Quil180/JuniorDesign/Reports/week6/Awad_Yousef_Week6.tex

\documentclass[12pt, letterpaper]{article}

% Required Packages
\usepackage[utf8]{inputenc}
\usepackage[margin=1in]{geometry}
\usepackage{graphicx}   % For including images
\usepackage{amsmath}    % For equations
\usepackage{float}      % For figure placement
\usepackage{booktabs}   % For professional tables
\usepackage{hyperref}   % For clickable links
\usepackage{array}      % REQUIRED for the table fix

% Title Information
\title{\textbf{EEL3926L Week 6 Laboratory: Datasheet and Research}}
\author{Yousef Alaa Awad \\ University of Central Florida}
\date{\today}

\begin{document}

\maketitle

\section{Introduction}
The objective of this laboratory was to research component specifications using datasheets and Ultra Librarian to define the necessary signal connections for the Junior Design Range Finder project. Additionally, the pinout for the MSP430G2553 microprocessor was analyzed to assign specific pins for I2C communication, ADC inputs, and GPIO control. A draft schematic was designed, and the software header library was modified to reflect these pin assignments.

\section{MSP430G2553 Pin Configuration (Procedure 3.1)}
Table 1 below details the specific pin assignments chosen for the MSP430G2553 chip based on the functional requirements of the project.

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

\pagebreak
\section{Component Signal Definitions (Procedure 3.2)}
Below are the defined signal connections for the components used in the Bill of Materials (BOM), based on their respective datasheets.

\subsection*{A. Battery Pack}
\begin{itemize}
	\item \textbf{Terminal 1:} 
	\item \textbf{Terminal 2:} 
\end{itemize}

\subsection*{B. Switch}
\begin{itemize}
	\item \textbf{Pin 1:} 
	\item \textbf{Pin 2:} 
  \item \textbf{Pin 3:} 
\end{itemize}

\subsection*{C. 3.3V Regulator PCB (Female Header)}
\begin{itemize}
	\item \textbf{Pin 1:}
	\item \textbf{Pin 2:}
	\item \textbf{Pin 3:}
	\item \textbf{Pin 4:}
\end{itemize}

\subsection*{D. 5V Regulator PCB (Female Header)}
\begin{itemize}
	\item \textbf{Pin 1:}
	\item \textbf{Pin 2:}
	\item \textbf{Pin 3:}
	\item \textbf{Pin 4:}
\end{itemize}

\subsection*{E. LCD Display (Male Header)}
\begin{itemize}
	\item \textbf{Pin 1:}
	\item \textbf{Pin 2:}
	\item \textbf{Pin 3:}
	\item \textbf{Pin 4:}
\end{itemize}

\subsection*{F. Ultrasonic Sensor (Female Header)}
\begin{itemize}
	\item \textbf{Pin 1:}
	\item \textbf{Pin 2:}
	\item \textbf{Pin 3:}
	\item \textbf{Pin 4:}
\end{itemize}

\subsection*{G. Potentiometer}
\begin{itemize}
	\item \textbf{Pin 1:}
	\item \textbf{Pin 2:}
	\item \textbf{Pin 3:}
\end{itemize}

\subsection*{H. BS170 MOSFET}
\begin{itemize}
	\item \textbf{Pin 1:}
	\item \textbf{Pin 2:}
	\item \textbf{Pin 3:}
\end{itemize}

\pagebreak
\section{Schematic and Header Library}

\subsection{Final Schematic Sketch (Procedure 3.3)}
Figure \ref{fig:schematic} shows the hand-drawn schematic sketch illustrating the connections defined in Section 2 and 3.

\begin{figure}[H]
	\centering
	% REPLACE 'schematic.png' with your actual file name
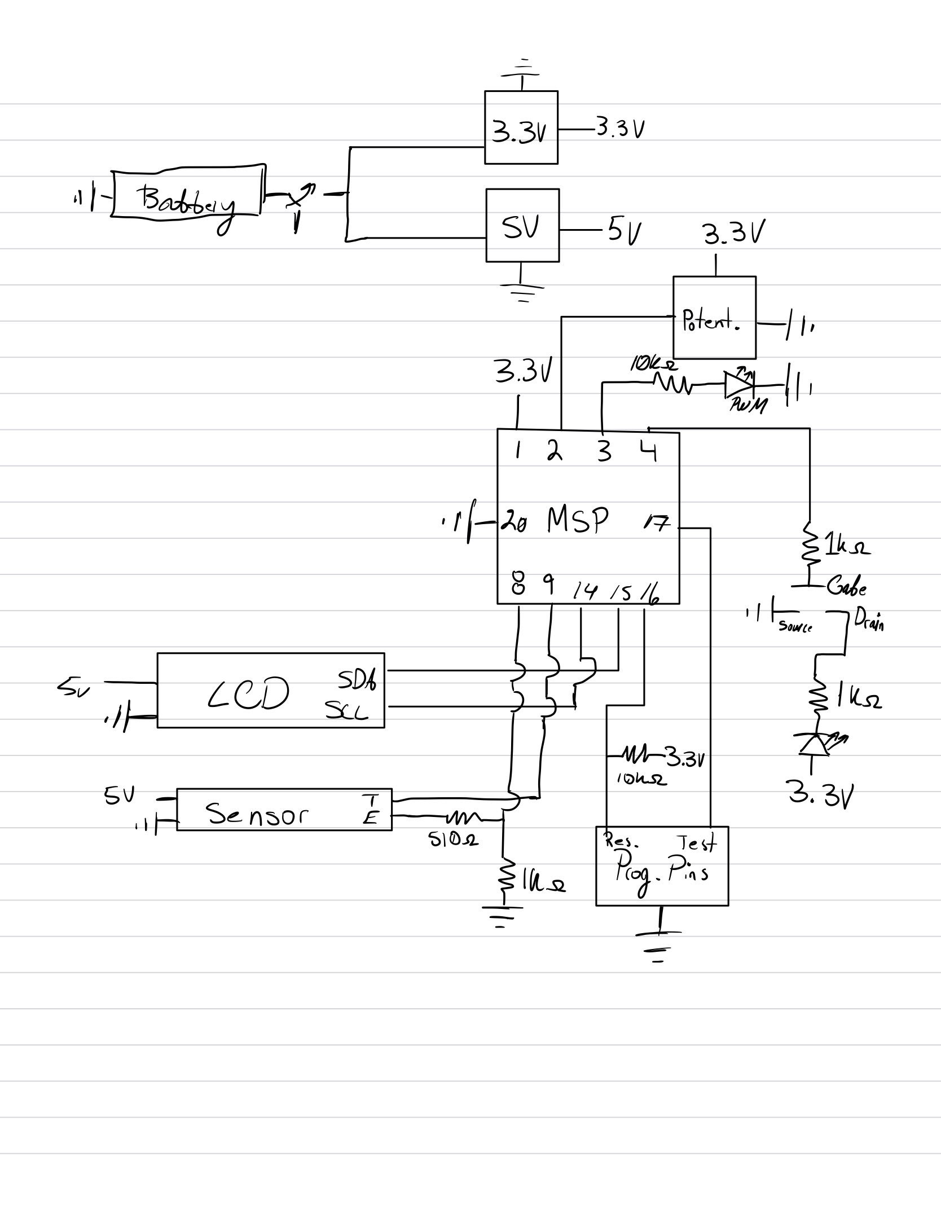
[picture p4: Reports/week6/schematic.jpg]
	
	\caption{Hand Drawn Schematic for Range Finder Project}
	\label{fig:schematic}
\end{figure}

\subsection{Modified Header Library (Procedure 3.4)}
Figure \ref{fig:header} shows the modifications made to the template header library (lines 88-96) to match the pin definitions.

\begin{figure}[H]
	\centering
	% REPLACE 'header_code.png' with your actual file name
	% \includegraphics[width=0.8\textwidth]{header_code.png}
	\fbox{\begin{minipage}{10cm}\vspace{5cm}\centering [Insert Header Screenshot Here]\end{minipage}}
	\caption{Screenshot of Modified Header Library Code}
	\label{fig:header}
\end{figure}

\section{Summary}
% Write a short summary of what you have learned in this lab (Procedure 4.0e).
In this laboratory, I learned the importance of thoroughly researching component datasheets before beginning the design phase. By defining the pinouts for the MSP430G2553 and the peripheral components, I gained a better understanding of how the subsystems (Power, I2C, ADC, GPIO) interact within the Range Finder project. This preparation ensures that the subsequent PCB design and software implementation will be based on verified signal connections.

\end{document}
