Quil180/JuniorDesign/Reports/week3/pics/5v_resistor_reading.jpg

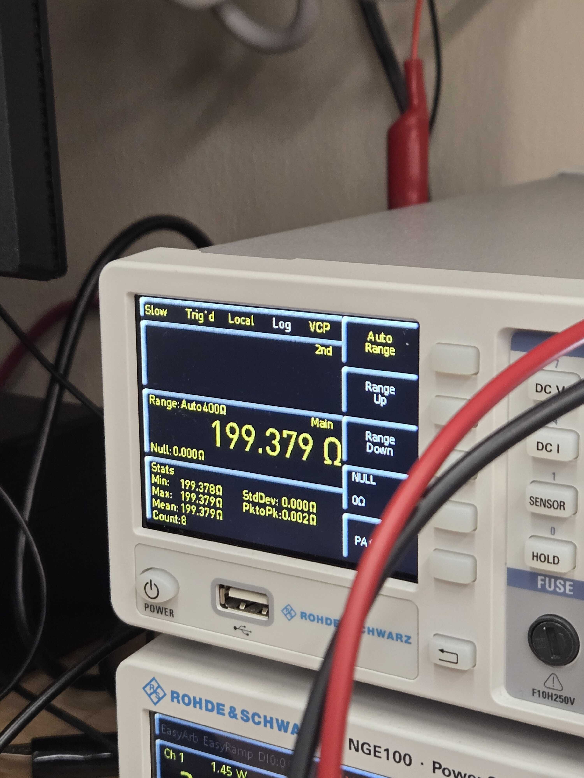
Reports/week3/pics/5v_resistor_reading.jpg
