Quil180/JuniorDesign/Reports/week3/pics/33v_Iin_powersupply.jpg

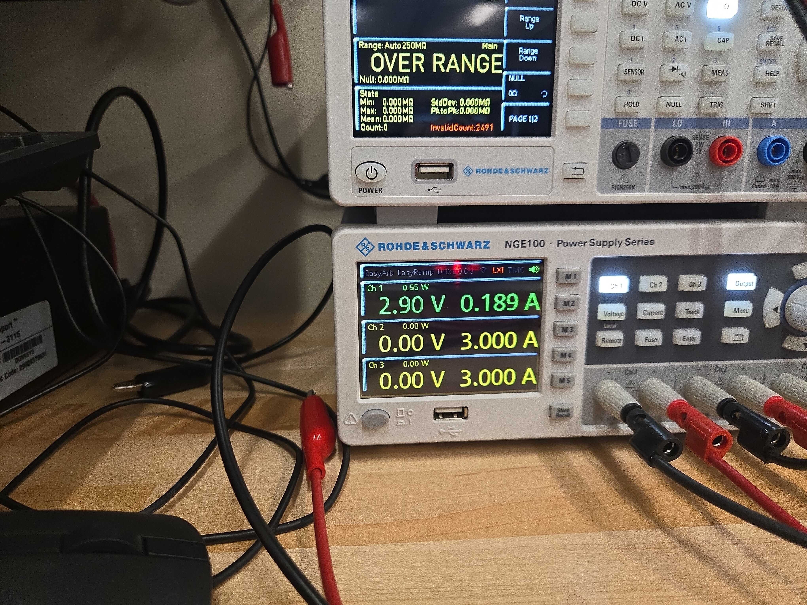
Reports/week3/pics/33v_Iin_powersupply.jpg
