Quil180/JuniorDesign/Reports/week3/pics/33v_vout_electronicload.jpg

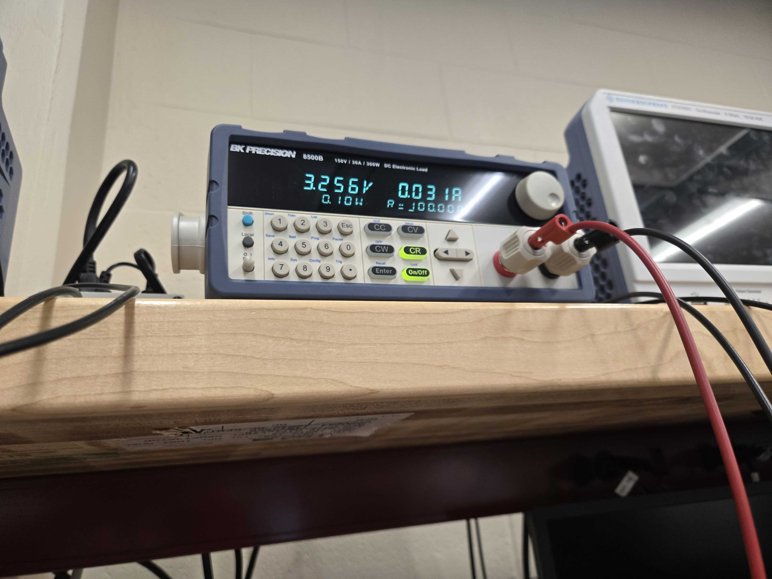
Reports/week3/pics/33v_vout_electronicload.jpg
