Quil180/JuniorDesign/Reports/week1/BOM.xlsx

Name | Number | Vendor | In Stock? | Delivery Date | Unit Price | Amount | Link
Hosyond 3pcs I2C IIC 1602 LCD Display Module | 732214748071 | Amazon | Y | 2026-01-15 | $4.33 | 3 | https://www.amazon.com/dp/B0BWTFN9WF?newOGT=1 | $12.99 | Autodesk License Proof:
HC-SR04 Ultrasonic Sensor Module (5 Sets) | 746591610333 | Amazon | Y | 2026-01-15 | $1.80 | 5 | https://www.amazon.com/dp/B01COSN7O6?psc=1&newOGT=1 | $8.99
BS170FTA 60V 0.15MA SMD Mosfet | BS170FCT-ND | Digikey | Y | 2026-01-21 | $1.08 | 1 | https://www.digikey.com/en/products/detail/diodes-incorporated/BS170FTA/53877 | $1.08
MSP430 G2553 IPW20R | 296-28430-1-ND | Digikey | Y | 2026-01-21 | $3.08 | 1 | https://www.digikey.com/en/products/detail/texas-instruments/MSP430G2553IPW20R/2638886 | $3.08
California JOS 1 PCS Breadboard 830 | B0BRQX6G3T | Amazon | Y | 2026-01-15 | $3.99 | 1 | https://www.amazon.com/dp/B0CJHT8T39?newOGT=1 | $3.99
WAYLLSHINE 2x1.5V AA Battery Holder Case Box | 607841995023 | Amazon | Y | 2026-01-15 | $0.36 | 100 | https://www.amazon.com/dp/B09R43HCY3?newOGT=1 | $35.99
Chanzon SPDT Mini Micro Slide Switch 1p2t 3mm | B09R43HCY3 | Amazon | Y | 2026-01-18 | $0.10 | 70 | https://www.amazon.com/dp/B09R43HCY3?newOGT=1 | $6.99
Honbay 6x6x4.3mm 4pin micro scm/smt button | B077N3D7BD | Amazon | Y | 2026-01-16 | $0.06 | 100 | https://www.amazon.com/dp/B077N3D7BD?newOGT=1 | $5.59
CL21A226MQQNNNE | 1276-1100-1-ND | Digikey | Y | 2026-01-21 | $0.12 | 4 | https://www.digikey.com/en/products/detail/samsung-electro-mechanics/CL21A226MQQNNNE/3886758 | $0.48
LQM18PN4R7MFRL | 490-12065-1-ND | Digikey | Y | 2026-01-21 | $0.17 | 2 | https://www.digikey.com/en/products/detail/murata-electronics/LQM18PN4R7MFRL/4359186 | $0.34
TPS613221ADBVR | 296-50502-1-ND | Digikey | Y | 2026-01-21 | $0.49 | 1 | https://www.digikey.com/en/products/detail/texas-instruments/TPS613221ADBVR/8638375 | $0.49
TPS613222ADBVR | 296-50503-1-ND | l | Y | 2026-01-21 | $0.49 | 1 | https://www.digikey.com/en/products/detail/texas-instruments/TPS613222ADBVR/8638376 | $0.49
Flutesan 12 Pieces 10K Ohm Trim Potentiometer | B09G9TBY38 | Amazon | Y | 2026-01-15 | $0.71 | 12 | https://www.amazon.com/dp/B09G9TBY38?newOGT=1 | $8.54
RC1206FR-0710KL | 311-10.0KFRCT-ND | Digikey | Y | 2026-01-21 | $0.10 | 1 | https://www.digikey.com/en/products/detail/yageo/RC1206FR-0710KL/728483 | $0.10
1206B473K500CT | 1292-1614-1-ND | Digikey | Y | 2026-01-21 | $0.11 | 2 | https://www.digikey.com/en/products/detail/walsin-technology-corporation/1206B473K500CT/9355111 | $0.22
RC1206FR-071KL | 311-1.00KFRCT-ND | Digikey | Y | 2026-01-21 | $0.11 | 1 | https://www.digikey.com/en/products/detail/yageo/RC1206FR-071KL/728387 | $0.11
RMCF1206JT510R | RMCF1206JT510RCT-ND | Digikey | Y | 2026-01-21 | $0.10 | 2 | https://www.digikey.com/en/products/detail/stackpole-electronics-inc/RMCF1206JT510R/1753855 | $0.20
CHANZON Super Bright Lighting Bulb | B01CUGA8JO | Amazon | Y | 2026-01-15 | $0.07 | 100 | https://www.amazon.com/dp/B01CUGA8JO?newOGT=1 | $6.99
MSP-EXP430G2ET | 296-50264-ND | Digikey | Y | 2026-01-21 | $11.99 | 2 | https://www.digikey.com/en/products/detail/texas-instruments/MSP-EXP430G2ET/9608004 | $23.98
Kystaii Straight Single Row 40 Pin .1 Male Header | B06ZZN8L9S | Amazon | Y | 2026-01-15 | $0.09 | 100 | https://www.amazon.com/dp/B06ZZN8L9S?newOGT=1 | $8.99
Female Pin Headers 4pin | 793481513595 | Amazon | Y | 2026-01-17 | $0.16 | 50 | https://www.amazon.com/dp/B08T5S54C5?newOGT=1 | $7.99
Dupont Wire All 3 Types | 746591610906 | Amazon | Y | 2026-01-15 | $0.06 | 120 | https://www.amazon.com/dp/B01EV70C78?psc=1&newOGT=1 | $6.98
Duracel AA Battery | 41333415017 | Amazon | Y | 2026-01-23 | $2.42 | 4 | https://www.amazon.com/dp/B074W8XFT8?newOGT=1 | $9.69
Total | $154.29
