Quil180/JuniorDesign/KicadProjects/main_pcb/main_pcb.kicad_pcb

## KiCad design KicadProjects/main_pcb/main_pcb.kicad_pcb (2026-03-13)

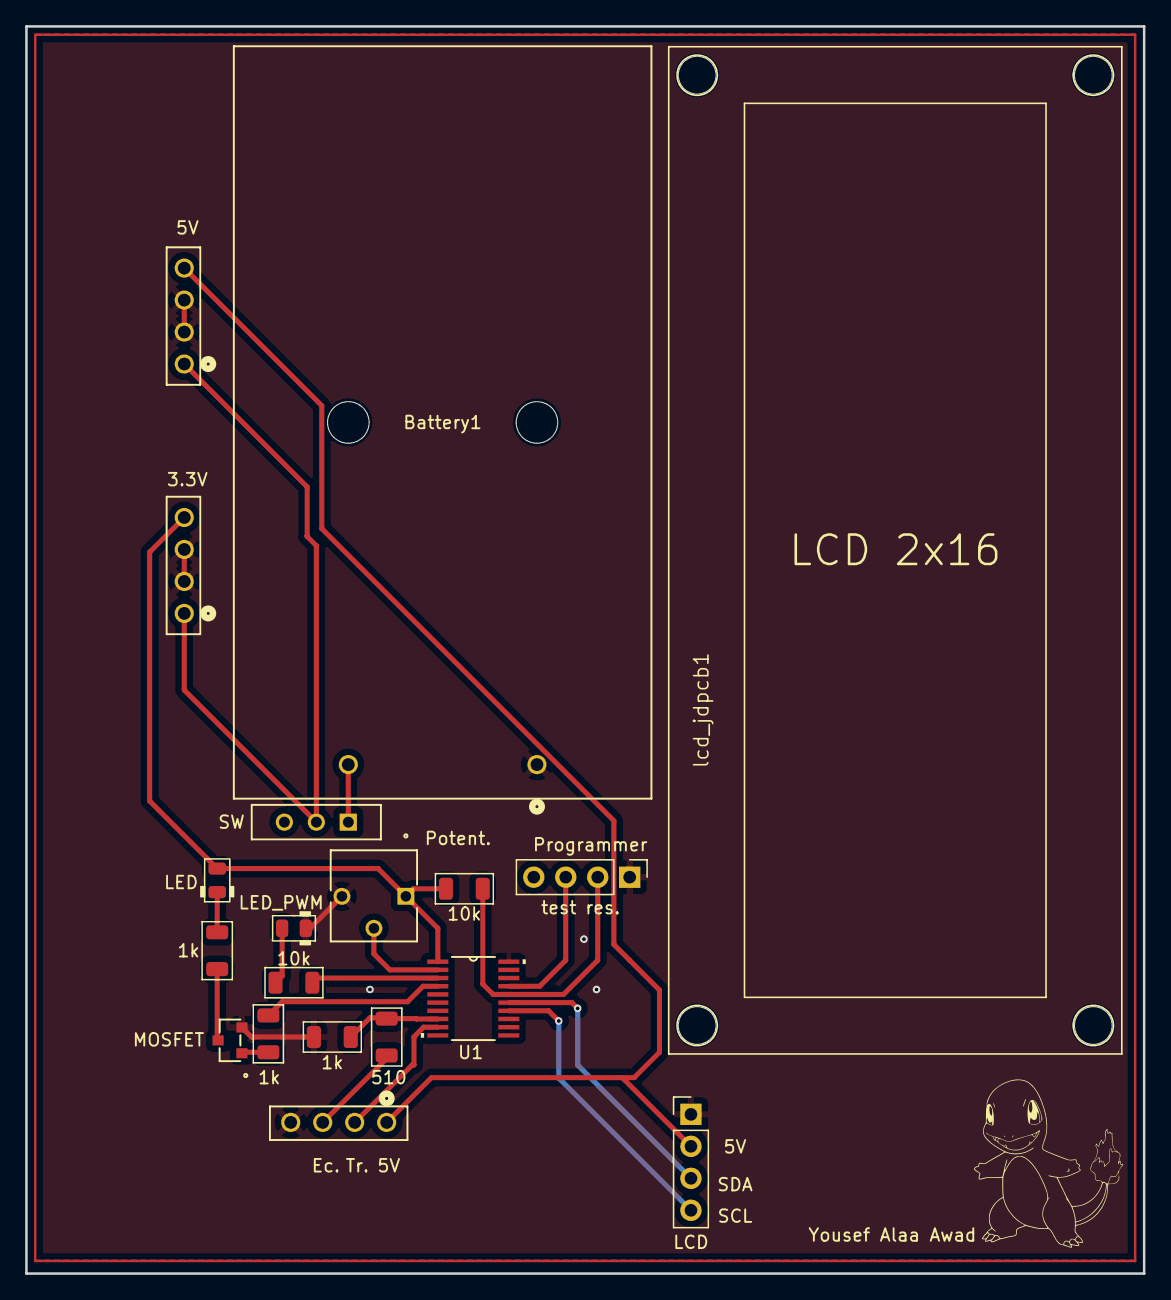
[picture p30: board main_pcb.kicad_pcb from above]

Board: 2 copper layers, 88.8 x 99.1 mm, 19 parts (0 on the bottom side), 19 nets.

Parts:
1k, 1k#2, 1k#3: 1k; R_1206_3216Metric
3.3V1, 5V1: Conn_01x04_Socket; CON4_1X4_TU_SSQ
10k, 10k#2: 10k; R_1206_3216Metric
510: 510; R_1206_3216Metric
Battery1: 2462; 2462_KEY
LCD: Conn_01x04_Pin; PinHeader_1x04_P2.54mm_Vertical
LED_MOSFET1: LED_0805_Red; LED_0805_2012Metric
LED_PWM: LED_0805_Red; LED_0805_2012Metric
MOSFET: BS170FTA; SOT-23_DIO
Potent.: 3362P-1-103LF; POT_3362P
Programmer: Conn_01x04_Pin; PinHeader_1x04_P2.54mm_Vertical
SW: 09.03201.02; 09.03201_EAO
Sensor1: Conn_01x04_Socket; CON4_1X4_TU_SSQ
U1: MSP430G2553IPW20R; PW20
lcd_jdpcb1: JHD-162A

Connections:
GNDPWR: 1k.2, 3.3V1.2 (GND), 3.3V1.3 (GND), 5V1.2 (GND), 5V1.3 (GND), Battery1.1, LCD.1 (GND), LED_PWM.1 (K), MOSFET.2 (S), Potent..3 (GND), Programmer.1 (GND), Sensor1.4 (GND), U1.20 (DVSS)
unnamed: 3.3V1.1 (Vin), 5V1.1 (Vin), SW.2
unnamed: 3.3V1.4 (Vout), 10k#2.2, LED_MOSFET1.2 (A), Potent..1 (3.3V), U1.1 (DVCC)
unnamed: 5V1.4 (Vout), LCD.2 (5V), Sensor1.1 (5V)
unnamed: Battery1.2, SW.1
unnamed: LCD.4 (SCL), U1.14 (P1.6/TA0.1/UCB0SOMI/UCB0SCL/A6/CA6/TDI/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)
unnamed: LCD.3 (SDA), U1.15 (P1.7/CAOUT/UCB0SIMO/UCB0SDA/A7/CA7/TDO/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)
unnamed: 1k#3.2, LED_MOSFET1.1 (K)
unnamed: 10k.1, LED_PWM.2 (A)
unnamed: 1k#3.1, MOSFET.3 (D)
unnamed: 1k#2.1, MOSFET.1 (G)
unnamed: 10k#2.1, Programmer.2 (Reset), U1.16 (*RST/NMI/SBWTDIO)
unnamed: Programmer.3 (Test), U1.17 (TEST/SBWTCK)
unnamed: 510.2, Sensor1.3 (Echo)
unnamed: Sensor1.2 (Trg.), U1.9 (P2.1/TA1.1)
unnamed: Potent..2, U1.2 (P1.0/TA0CLK/ACLK/A0/CA0)
unnamed: 10k.2, U1.3 (P1.1/TA0.0/UCA0RXD/UCA0SOMI/A1/CA1)
unnamed: 1k#2.2, U1.4 (P1.2/TA0.1/UCA0TXD/UCA0SIMO/A2/CA2)
unnamed: 1k.1, 510.1, U1.8 (P2.0/TA1.0)
