Quil180/JuniorDesign/KicadProjects/regulator_daughter_board/regulator_daughter_board.kicad_pcb

## KiCad design KicadProjects/regulator_daughter_board/regulator_daughter_board.kicad_pcb (2026-03-12)

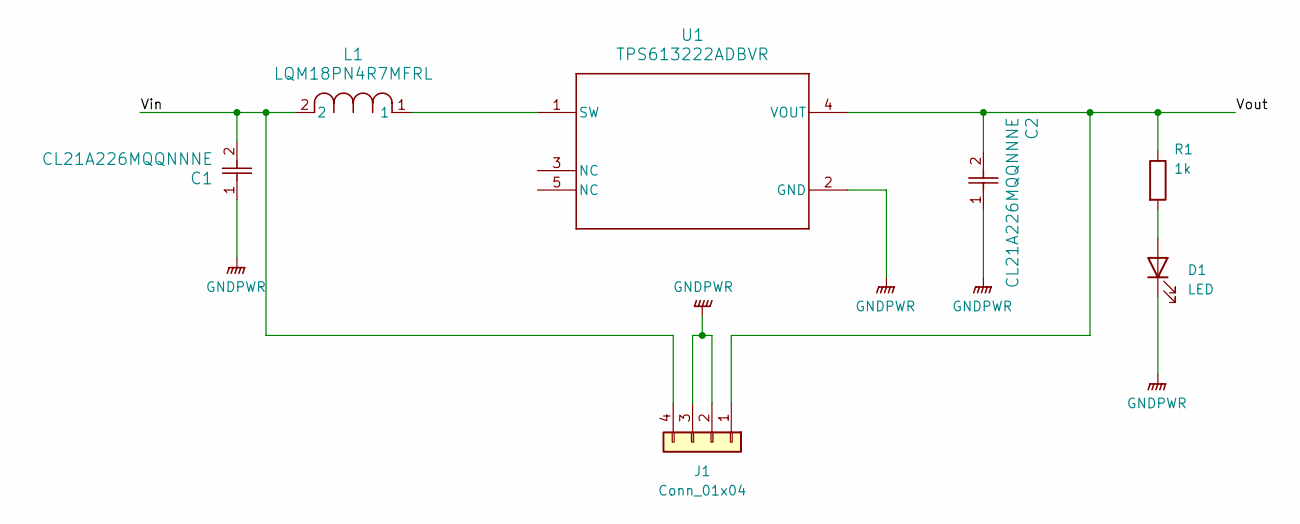
[picture p31: schematic regulator_daughter_board.kicad_sch]

Parts:
C1, C2: CL21A226MQQNNNE; CAP_CL21_SAM
D1: LED; LED_0805_2012Metric
J1: Conn_01x04; PinHeader_1x04_P2.54mm_Vertical
L1: LQM18PN4R7MFRL; IND_LQM18PxxxxFRx_MUR
R1: 1k; R_1206_3216Metric
U1: TPS613222ADBVR; DBV0005A_N

Connections:
/Vin: C1.2, J1.4, L1.2
/Vout: C2.2, J1.1, R1.1, U1.4 (VOUT)
GNDPWR: C1.1, C2.1, D1.1 (K), J1.2, J1.3, U1.2 (GND)
unnamed: D1.2 (A), R1.2
unnamed: L1.1, U1.1 (SW)

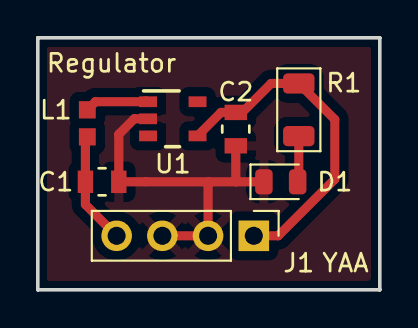
[picture p32: board regulator_daughter_board.kicad_pcb from above]

Board: 2 copper layers, 19.0 x 14.0 mm, 7 parts (0 on the bottom side), 5 nets.
