Quil180/JuniorDesign/(commit log)

2026-02-03 finished like week 3
    [BOM.xlsx]
2026-02-20 uploading a lot of sttuff
    [Ordered_inputFile.csv, PnP_Junior_Reg_front.csv, StudentOutputFile.csv, Template.csv, regulator_daughter_board.csv, regulator_daughter_board.kicad_pcb, regulator_daughter_board.kicad_sch]
2026-03-04 updating backups for daughter board
2026-03-04 renamed library files
    [main_pcb.kicad_pcb, main_pcb.kicad_sch]
2026-03-04 finished schematic for main board
    [main_pcb.kicad_sch]
2026-03-12 main board version 1 finished, awaiting review, no drc left
    [main_pcb.kicad_pcb, main_pcb.kicad_sch]
2026-03-13 main board finished
    [main_pcb.kicad_pcb]
