Quil180/JuniorDesign/Reports/week3/pics/33v_breadboard_1.jpg

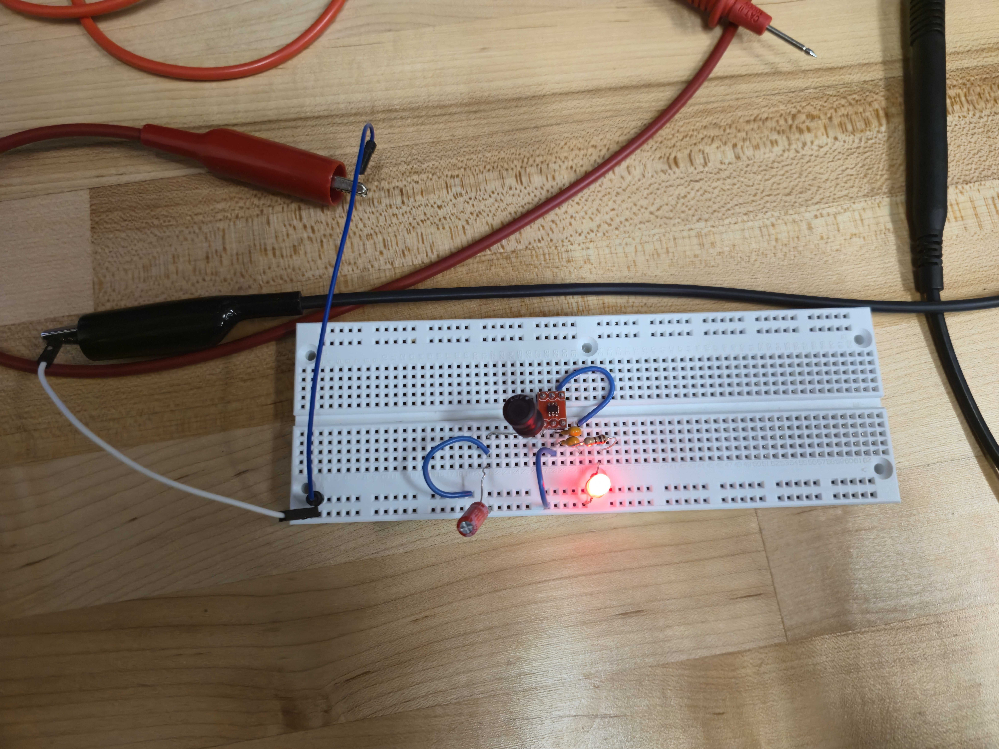
[picture p5: Reports/week3/pics/33v_breadboard_1.jpg]
Reports/week3/pics/33v_breadboard_1.jpg
