Quil180/JuniorDesign/Reports/week3/pics/33v_breadboard_side.jpg

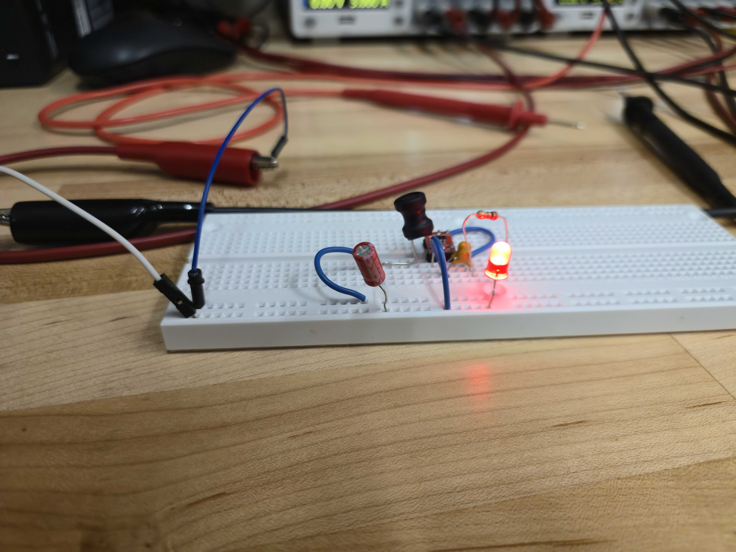
Reports/week3/pics/33v_breadboard_side.jpg
